madhacker3kxl/Senior-2-AlarmSystem/FinalReport.pdf

Version: (C4) | Date: 04/30/2015

“…Because Everyone Deserves to Feel Safe!”

Version: (C4)

Date: 04/30/2015

1

# TABLE OF CONTENTS

Version: (C4)
2

Version: (C4)
3

## 1. PROJECT DEFINITION

### 1.1 Functions

Ninja Security is an exciting new security system that caters to all people. Formerly designed to cater to the deaf and hard-of-hearing, Ninja Security can help keep you and your family secure regardless of special needs.

Features include:
- Loud siren to alarm owners, neighbors, and intruders that alarm system has tripped
- Flashing lights to signal alarm and alarm delays for those who cannot hear or would have trouble hearing the siren and beeps.
- Bed shaker to signal alarm during night hours for hard sleepers or deaf/hard-of-hearing.
- Door and windows sensors
- Integrated doorbell with customized tones and flash sequence to the security system for audio and visual alerts when someone arrives at the residence.
- Motion sensor to alert unwanted movement inside the home while away.
- Panic button to immediately trip alarm in case of emergencies.
- LCD interface for visual status and current updates.
- Add and remove features, expandable and customizable to meet your personal needs.

### 1.2 Customer

This system was originally geared toward the deaf and hard-of-hearing, this security system can be used by anyone. We have surveyed deaf, hard-of-hearing, and hearing people alike to determine which features are most important to them in accordance with their lifestyles. After analyzing the data from these surveys, we believe our product will be preferred over any other.

### 1.3 Team Identity

Ninja Security
- Jesse Daniels – Project Engineer

Version: (C4)
4
- Tahsin Rahman – Design & Development Engineer
- Thomas Manahl – Systems Engineer
- Chanh Tran | – Support Engineer

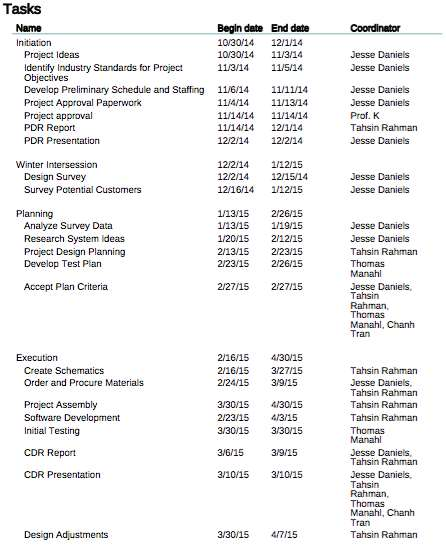
[picture p1: figure]

Version: (C4)
5

## 2. WBS

### 2.1 WBS

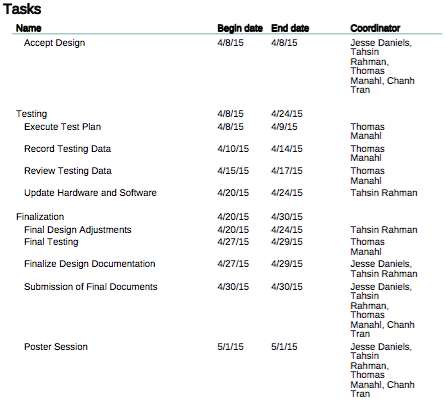
[picture p2: figure]

Version: (C4)
6

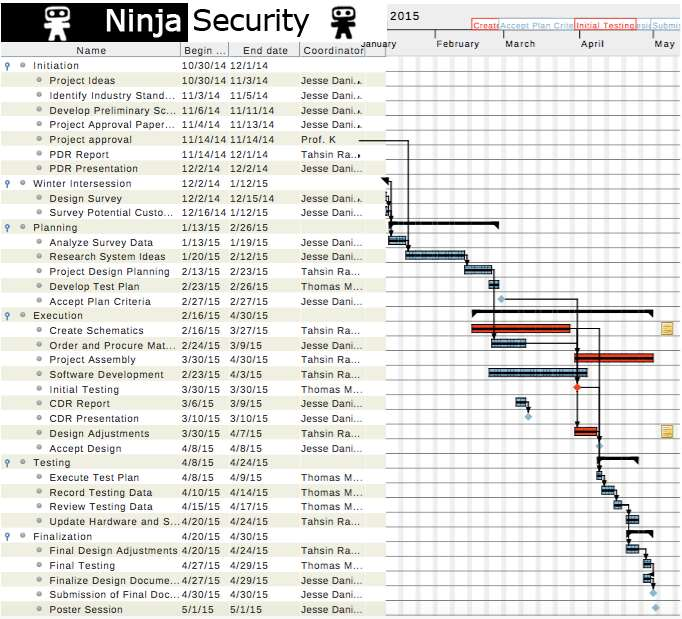
[picture p3: figure]

Version: (C4)
7

### 2.2 Schedule

- Actual Project Gantt Chart

See GANTT.pdf for larger version

## 3. SPECIFICATIONS (SUMMARY)

### 3.1 Microcontroller

- ATmega328p
- For Testing
- 8-bit
- 28 pin PDIP

Version: (C4)
8
- Operating Voltage | 1.8 – 5 Volts
- Digital I/O Pins | 14
- Analog Input Pins | 6 (10 bit)
- I/O Pin Current | 40 mA
- Flash Memory | 32 KB
- SRAM | 2 KB
- EEPROM | 1 KB
- Clock Speed | 16 MHz
- External crystal
- Detailed specification at Attachment P1
- ATtiny85
- Production
- 8-bit
- 8 pin PDIP
- Operating Voltage | 2.7 – 5 Volts
- Digital I/O Pins | 6
- Analog Input Pins | 4 (10 bit)
- I/O Pin Current | 40 mA
- Flash Memory | 32 KB
- SRAM | 512 B
- EEPROM | 512 B
- Clock Speed | 1 MHz
- Internal Calibrated RC Oscillator
- Detailed specification at Attachment P2

### 3.2 RF Modules

- Transmitter
- Frequency: 433Mhz
- Modulation: Amplitude-shift keying (ASK)
- Transmitter Input Voltage: 3-12V
- High voltage = more transmitting power
- Transmitting range @5V: 40m indoor, and 100m in open air

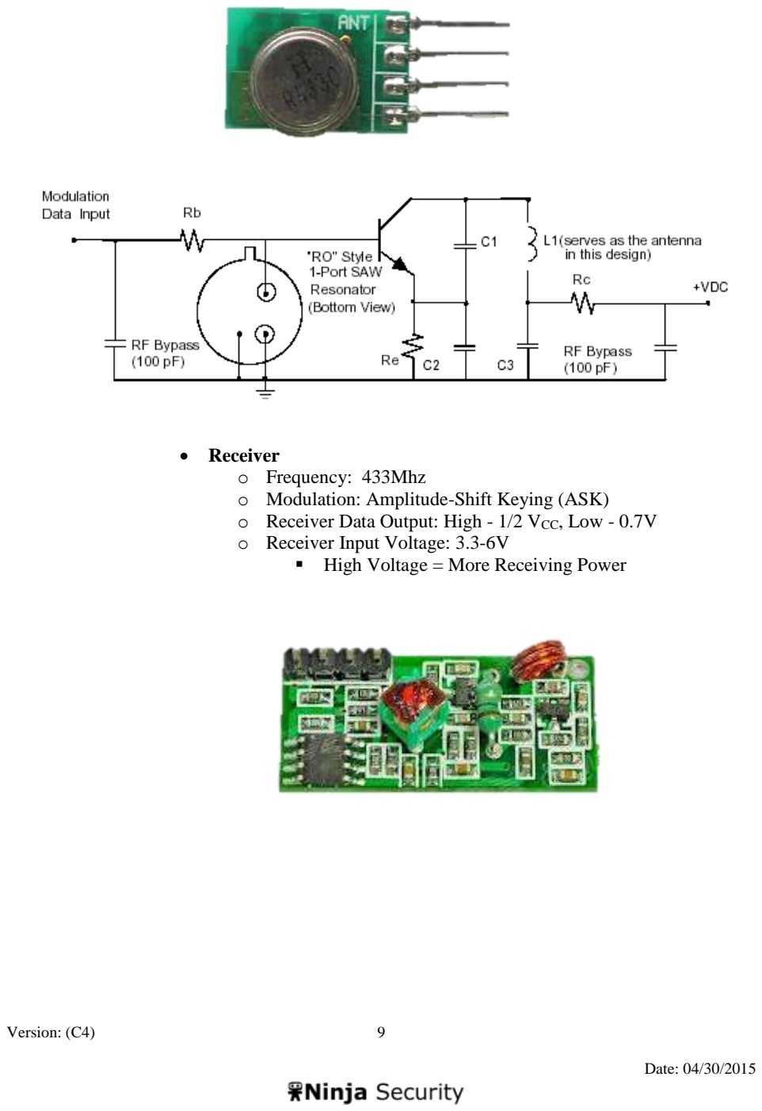
[picture p4: page 10]

Version: (C4)
9
- Receiver
- Frequency: 433Mhz
- Modulation: Amplitude-Shift Keying (ASK)
- Receiver Data Output: High - 1/2 VCC, Low - 0.7V
- Receiver Input Voltage: 3.3-6V
- High Voltage = More Receiving Power

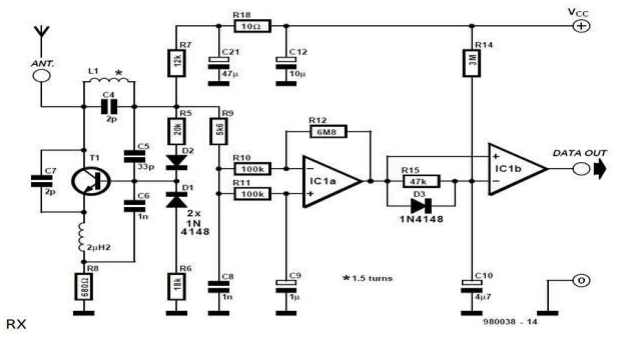
[picture p5: figure]

Version: (C4)
10

### 3.3 Sensors

- Door / Window
- Operation Current:30mA
- Idle Current: 8uA
- Operation Frequency: 433MHz
- Modulation: Amplitude-Shift Keying (ASK)
- Transmission Time: ≈ 1s
- Operating Voltage: 12V, 3V
- 12Volt for RF
- 3Volt for MCU
- Transmit Range: approx. 100M line-of-sight,
- Operation Temp: -10C~50C; Humidity: ≤90%
- Dimension: 71mm*36mm*15mm

Version: (C4)

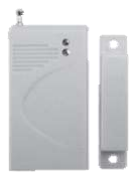
[picture p6: figure]
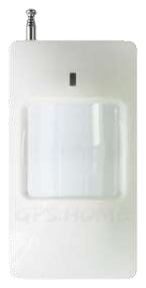
[picture p7: figure]

11

- Motion
- Power Supply : 9V
- Static current : 1 ≤ 30mA
- Alarm current : 2 ≤ 20μA
- Frequency: 433Mhz
- Transmission Time : ≧1s
- Detected Distance : 5-8m
- Transmit Distance : approx. 100m Line-of-sight
- Detect angle : Horizontal: 110, Vertical: 60
- Working Condition : Temperature : -10°C ~ 40°C (approx. 14°F ~104°)
- Panic Button / Doorbell
- Operation Current

Version: (C4)

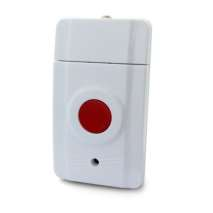
[picture p8: figure]

12

- Standby: 1uA
- Operating Current: 10mA
- Operation Frequency: 433MHz
- Modulation: Amplitude-shift keying (ASK)
- Transmission Time : ≧1s
- Operating Voltage: 12V
- Transmit Range: approx. 100M line-of-sight,
- Operation Temp: -10C~50C;Humidity:≤95%
- Dimension:65cm*38mm*15mm

### 3.4 Audio / Visual

- Fire alarm
- Modified fire alarm
- High dB Output
- up to 87.9 dBA @ 10ft
- Frequency Range 400-4000Hz
- Speaker voltage 25
- Field selectable power taps: 1/8W, 1/4W, 1/2W, 1W, 2W, 4W
- Xenon Strobe
- Maintains Constant Flash Rate (1Hz) Regardless of Input Voltage
- 75 candela light output

Version: (C4)

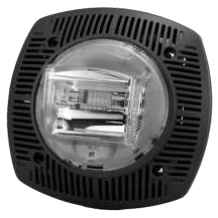
[picture p9: figure]
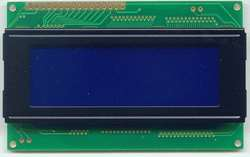
[picture p10: figure]

13

- LCD Display
- Custom alarm display box
- Operation Frequency: 433MHz
- Modulation: Amplitude-shift keying (ASK)
- Operating Voltage: 5V
- Operating Current: 100mA
- ATmega328p MCU
- 16MHz
- Capable of both sending and receiving data

### 3.5 Seismic Feedback

- Bed Shaker
- 12 volt operating voltage
- Built-in temperature sensor protects the unit against overheating
- Claims to wake up extremely heavy sleepers
- Ideal for Deaf and Hard-of-Hearing

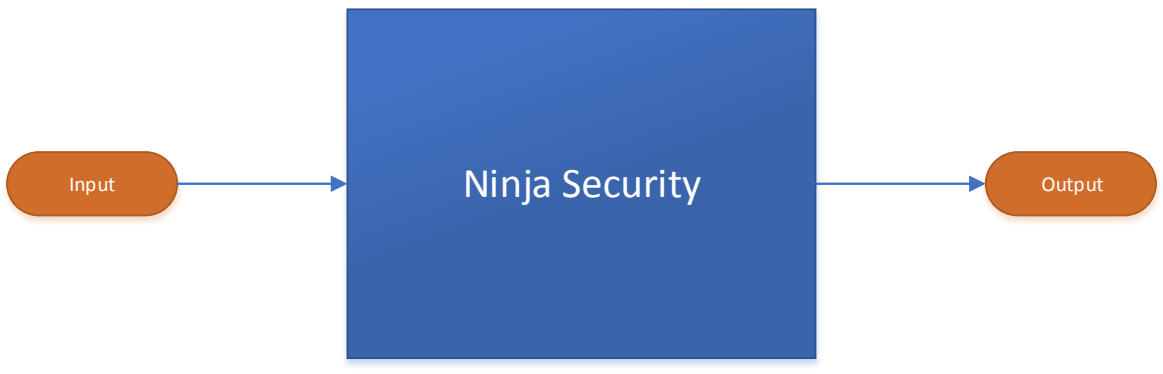
[picture p11: figure]
Input; Ninja Security; Output

Version: (C4)

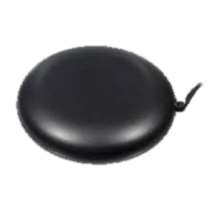
[picture p12: figure]

14

## 4. FUNCTIONAL DECOMPOSITION DIAGRAM

### 4.1 Level 0

- Input
- Various input for the main system
- Output
- Data output to various systems

### 4.2 Level 1

- Input
- Window Sensor
- Wireless magnetic window sensor
- Window opens or closes
- Door Sensor
- Wireless magnetic door sensor
- Door opens or closes

Version: (C4)
15
- Motions Sensor
- PIR based wireless motion sensor
- Movement within motion range
- Panic Button
- In case of emergencies button
- Push Button
- Door Bell Button
- Visitor at door alert
- Push Button
- Output
- Visual
- Sends data to local visual systems
- Audio
- Sends data to local audio feedback system
- Seismic
- Sends data to local vibration feedback system

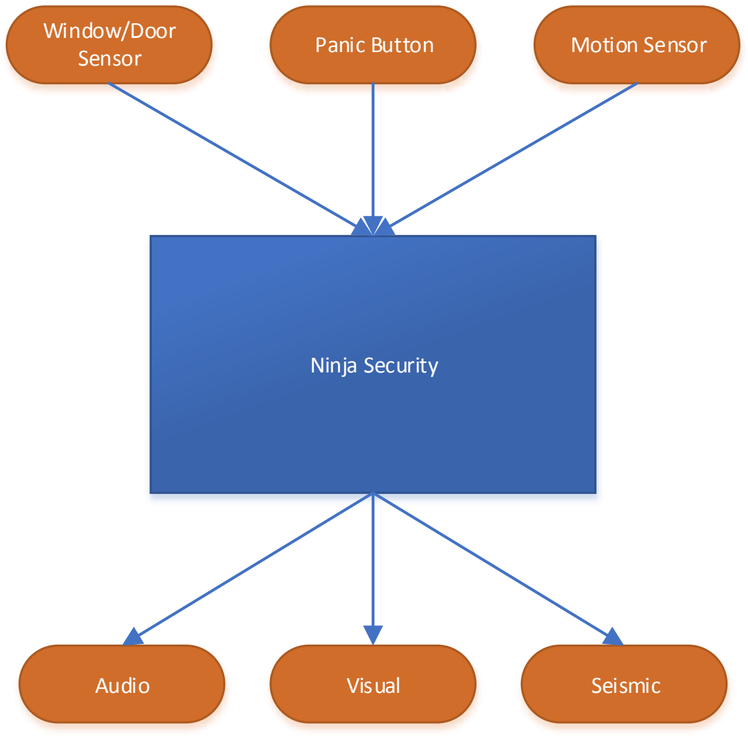
[picture p13: figure]
Ninja Security; Window/Door Sensor; Audio; Visual; Seismic; Panic Button; Motion Sensor

Version: (C4)
16

### 4.3 Level 2

- Input – Window/Door Sensor
- Battery
- 12Volt A23 Battery
- Magnets
- To open and close the magnetic relay
- Output
- RF Output
- 433MHz ASK
- Different open and close codes

Version: (C4)

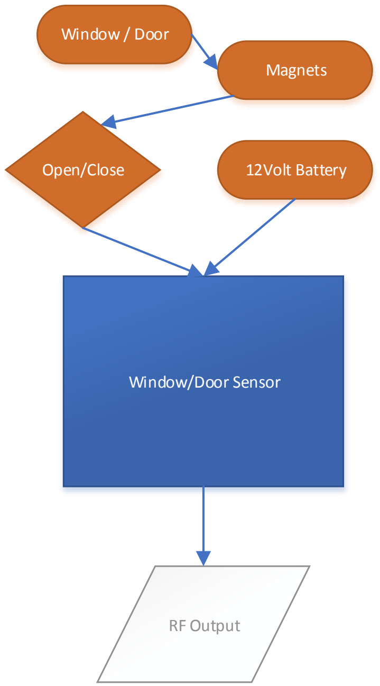
[picture p14: figure]
Window/Door Sensor; 12Volt Battery; Magnets; Open/Close; RF Output; Window / Door

17

- Input – Panic Button
- Button
- Tells the unit to send the data
- Battery

Version: (C4)

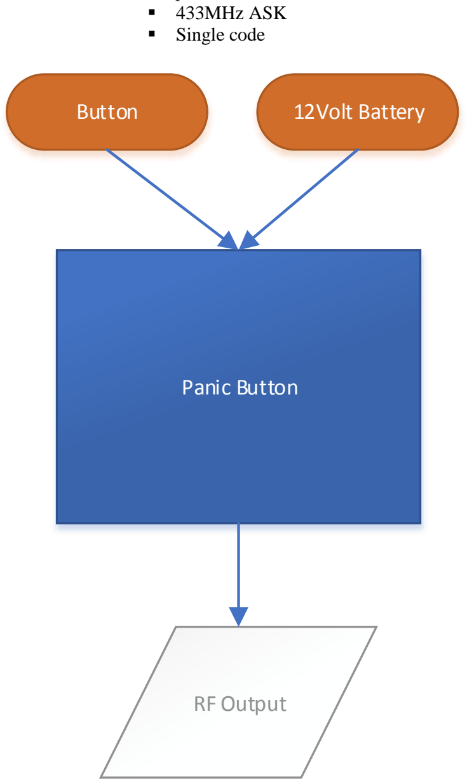
[picture p15: figure]
▪ 433MHz ASK ▪ Single code; Panic Button; Button; 12Volt Battery; RF Output

18

- 12Volt A23 Battery
- Output
- RF Output
- Input – Motion Sensor
- PIR Module
- Tells the unit to send that it detected a person
- Battery
- 9Volt Battery

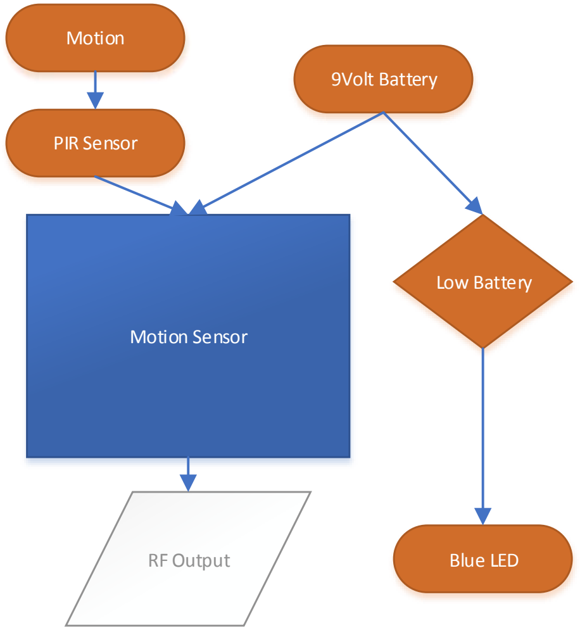
[picture p16: figure]
Motion Sensor; 9Volt Battery; PIR Sensor; RF Output; Low Battery; Blue LED; Motion

Version: (C4)
19
- Output
- RF Output
- 433MHz ASK
- Single code
- Low battery
- Blue LED is turned on for low battery
- Input – Audio Feedback
- RF Data
- RF data it received from the main system
- Power
- 12Volt AC adapter
- Output
- Speaker

Version: (C4)

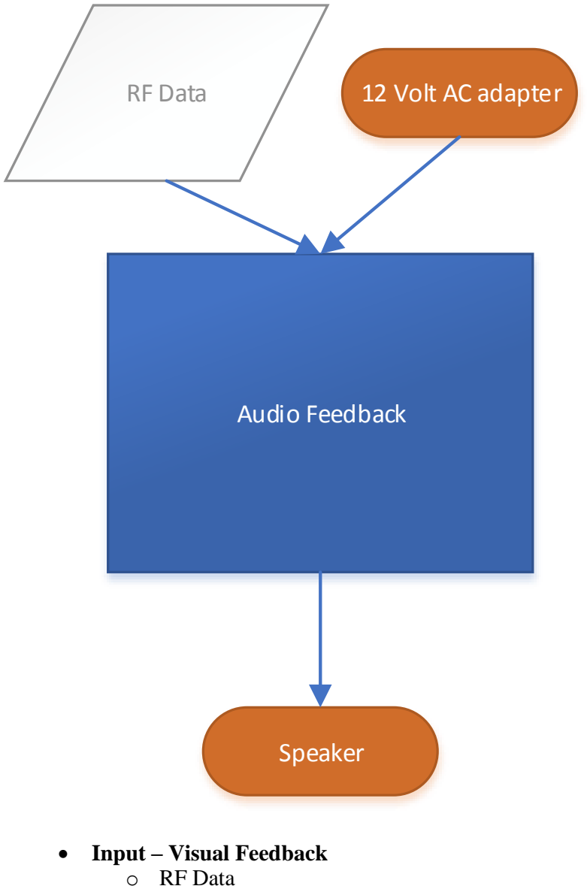
[picture p17: figure]
Audio Feedback; RF Data; 12 Volt AC adapter; Speaker; • Input – Visual Feedback • RF Data

20

- Play different sounds
- RF data it received from the main system
- Power
- 12Volt AC adapter
- Output
- Strobe
- 1Hz flashing arc strobe

Version: (C4)

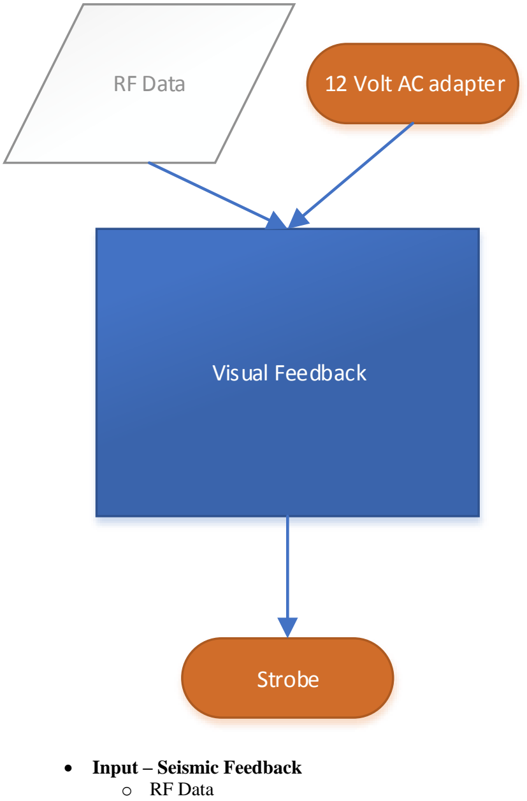
[picture p18: figure]
Visual Feedback; RF Data; 12 Volt AC adapter; Strobe; • Input – Seismic Feedback • RF Data

21

- RF data it received from the main system
- Power
- 12Volt AC adapter
- Output
- Bed shaker
- Pulsed and continuous modes

Version: (C4)

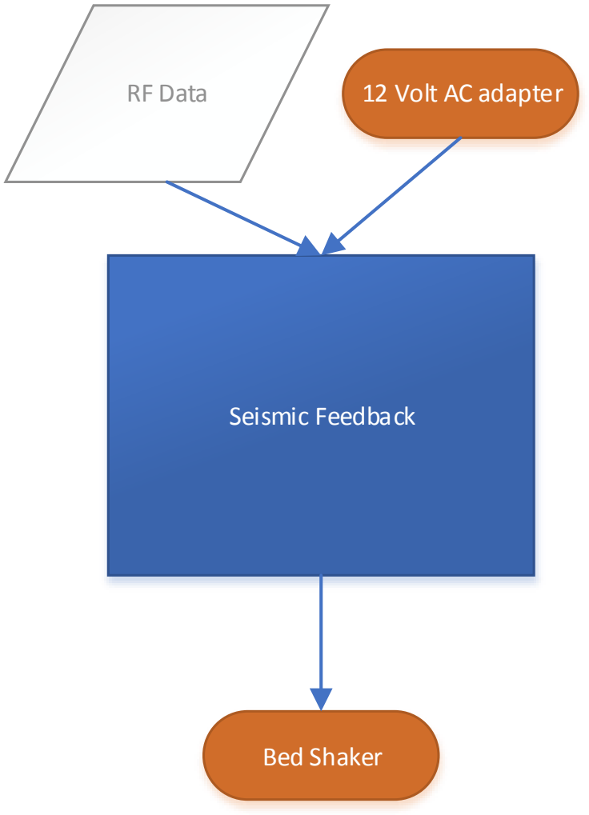
[picture p19: figure]
Seismic Feedback; RF Data; 12 Volt AC adapter; Bed Shaker

22

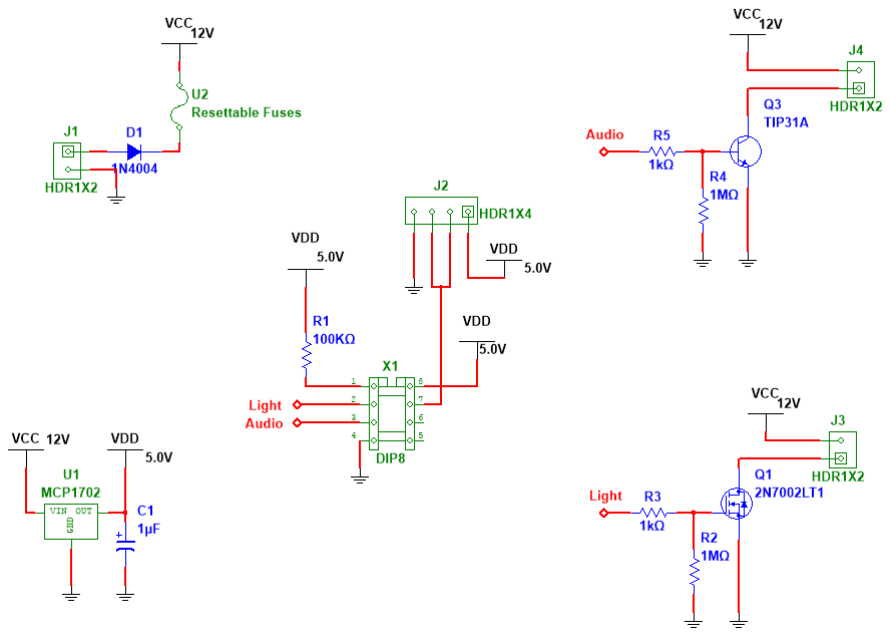
[picture p20: figure]

Version: (C4)
23

## 5.0 DESIGN CONCEPTS

### 5.1 Audio / Visual

Schematic

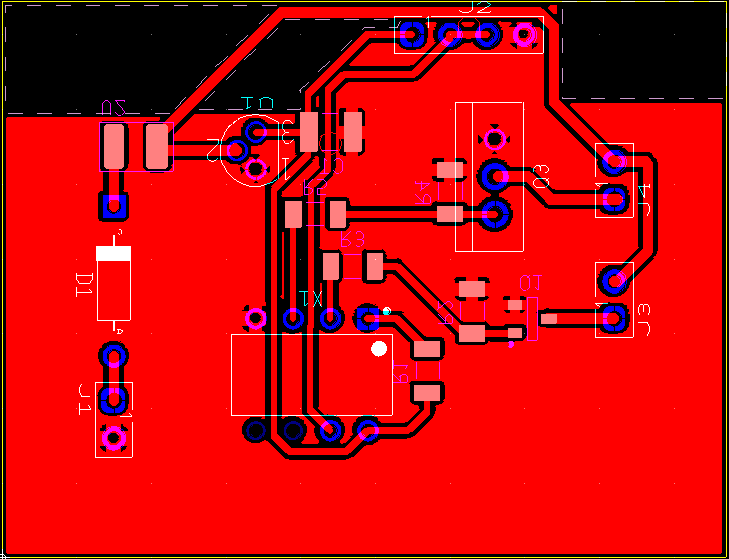
[picture p21: figure]

Version: (C4)
24

Board Layout

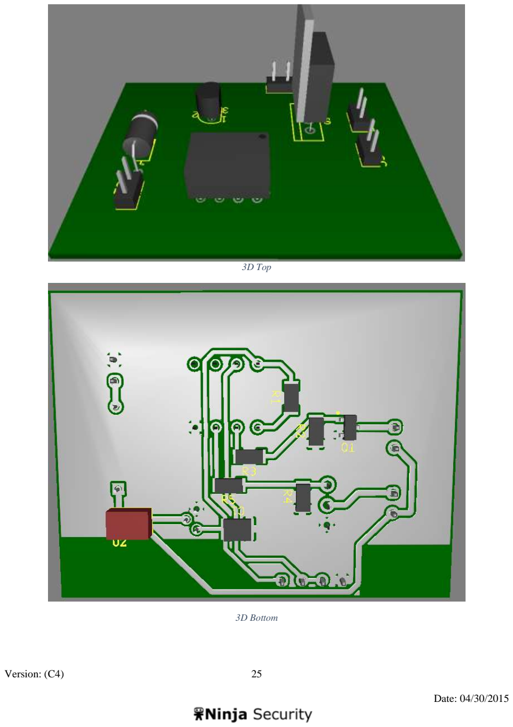
[picture p22: page 26]

Version: (C4)
25

3D Top

3D Bottom

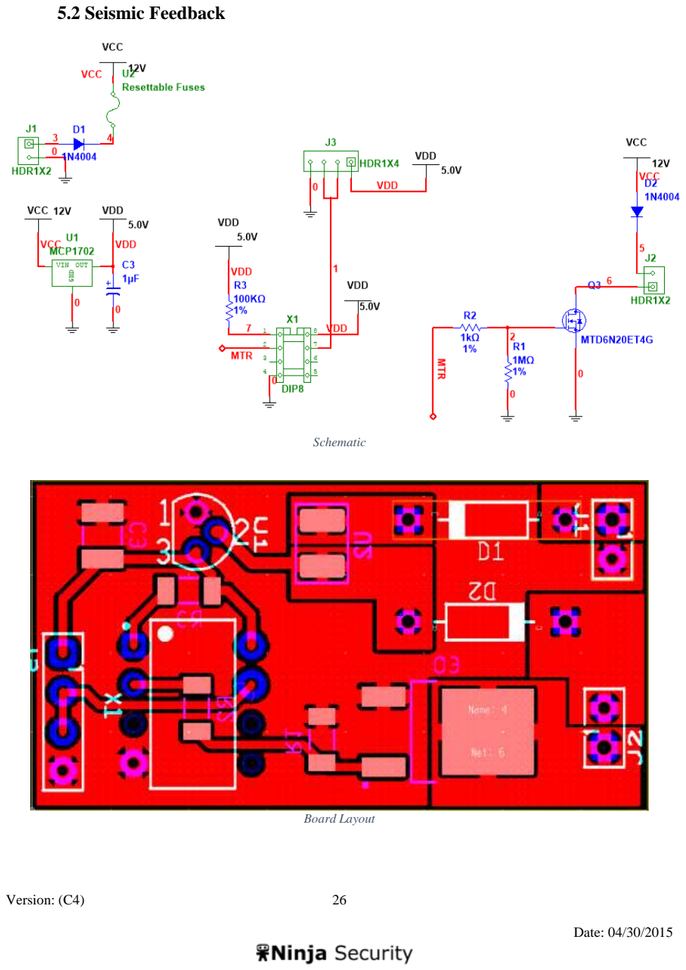
[picture p23: page 27]

Version: (C4)
26

### 5.2 Seismic Feedback

Schematic

Board Layout

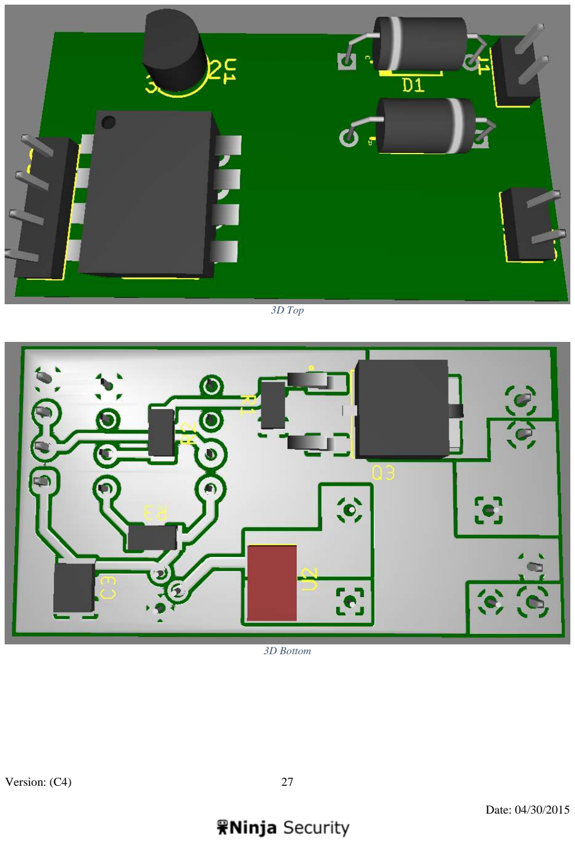
[picture p24: page 28]

Version: (C4)
27

3D Top

3D Bottom

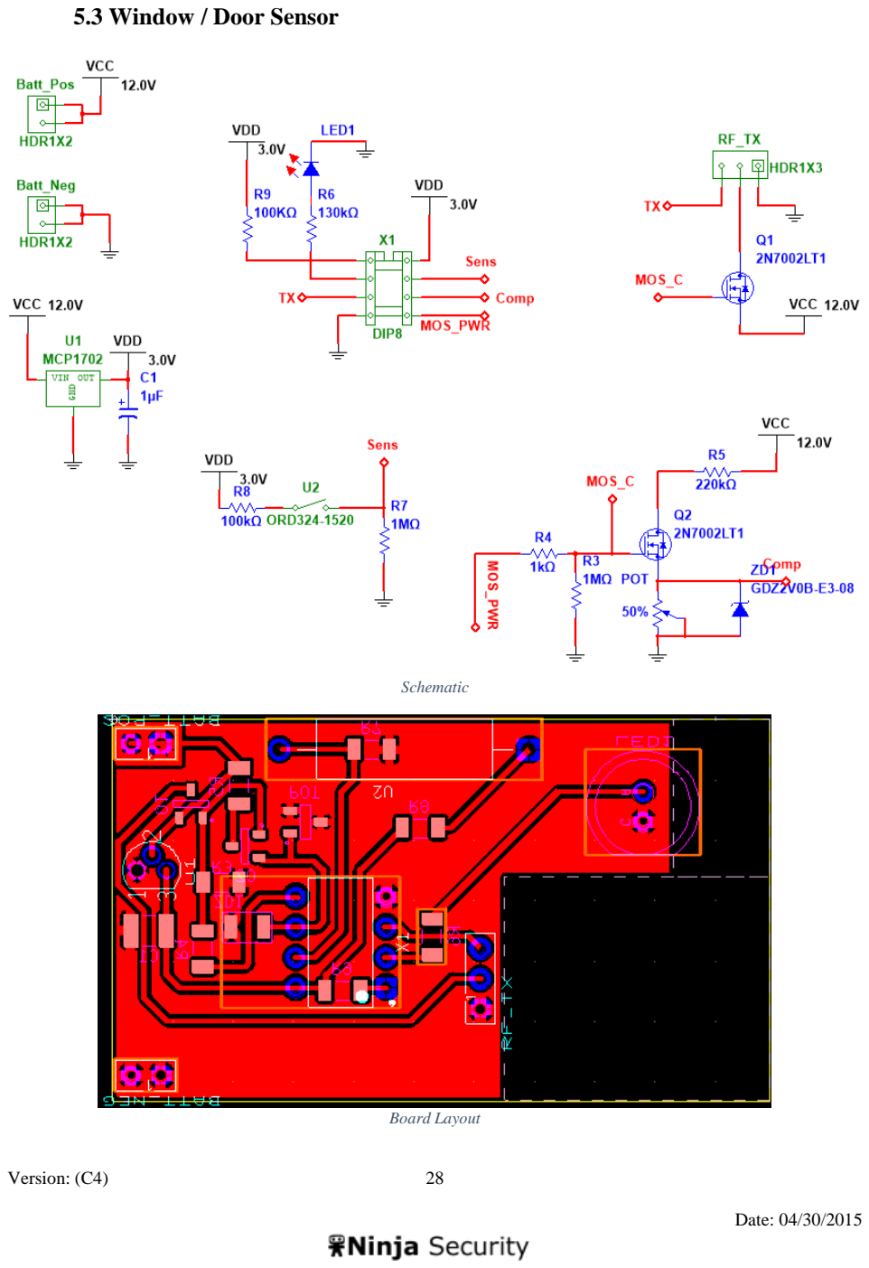
[picture p25: page 29]

Version: (C4)
28

### 5.3 Window / Door Sensor

Schematic

Board Layout

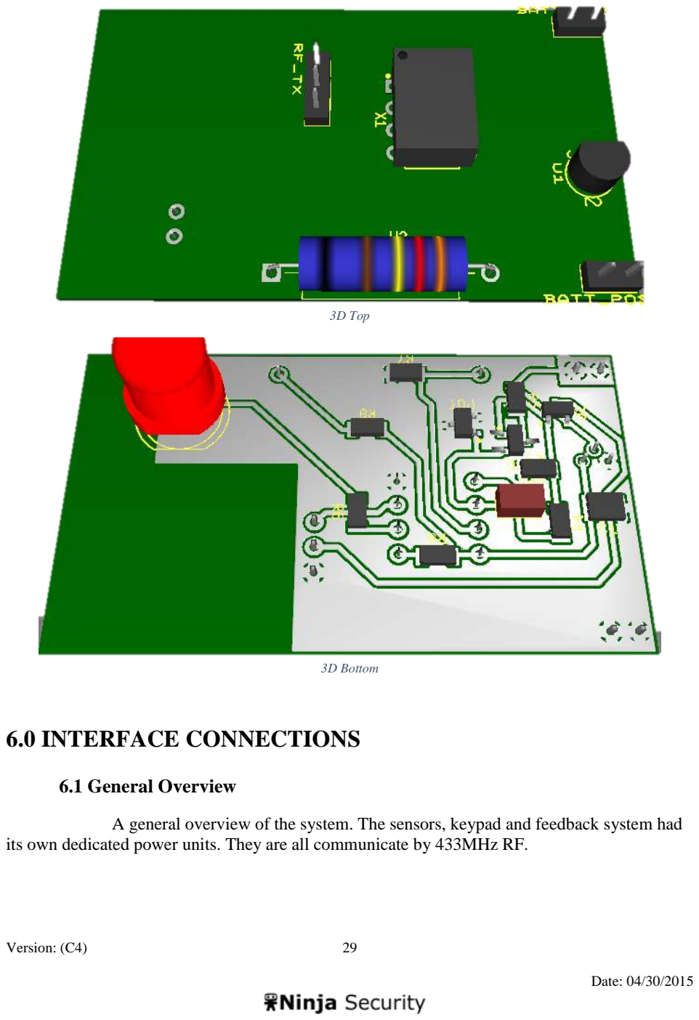
[picture p26: page 30]

Version: (C4)
29

3D Top

3D Bottom

## 6.0 INTERFACE CONNECTIONS

### 6.1 General Overview

A general overview of the system. The sensors, keypad and feedback system had its own dedicated power units. They are all communicate by 433MHz RF.

Version: (C4)

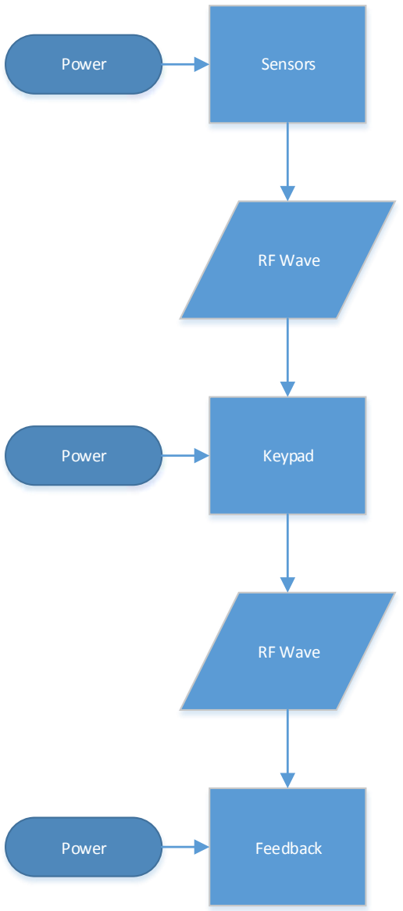
[picture p27: figure]
Keypad; Sensors; Feedback; RF Wave; Power

30

### 6.2 Display Panel

The display panel is considered as a central hub of the system. It is powered by a 12Volt adapter from the mains. The voltage regulator then converts the power to 5Volts to power the LCD, MCU, RF receiver. The MCU gets its data from the RF receiver through one of its general purpose input-output pins (GPIO). The MCU outputs data to three systems. The LCD, mini buzzer and RF transmitter is connected through GPIO pins.

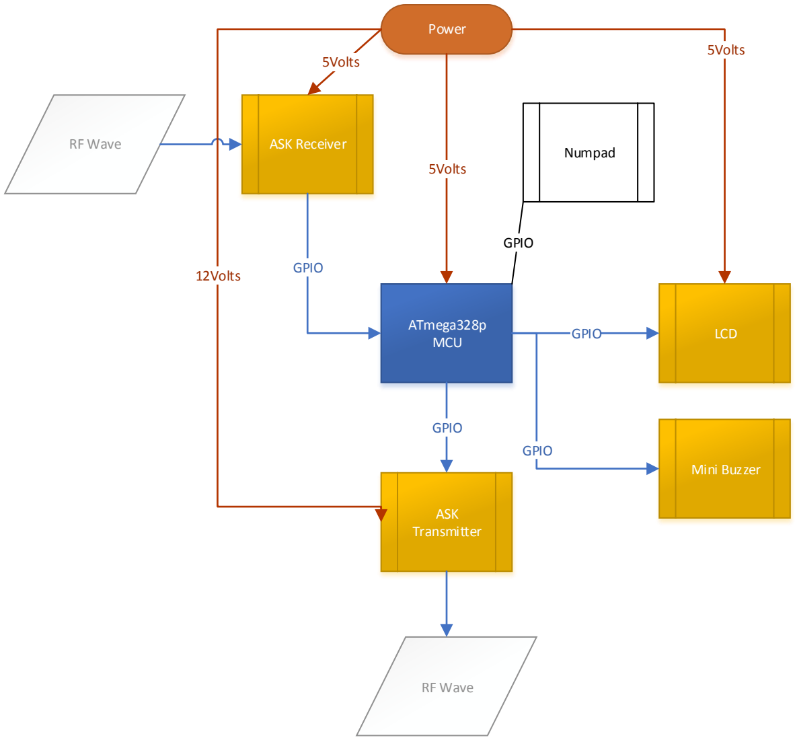
[picture p28: figure]
ATmega328p MCU; ASK Receiver; GPIO; RF Wave; Power; 5Volts; LCD; Mini Buzzer; ASK Transmitter; 12Volts; Numpad

Version: (C4)
31

### 6.3 Sensors

The motion and the panic button is powered by a 9Volt or a 12Volt A23 battery. The regulator then takes the power to 5 volts to power the BQ series device. The raw input power is also connected to the RF transmitter. The BQ series device get its input from a button / motion information through GPIO pin. Then it sends the data out to the RF transmitter using a different set of GPIO pin.

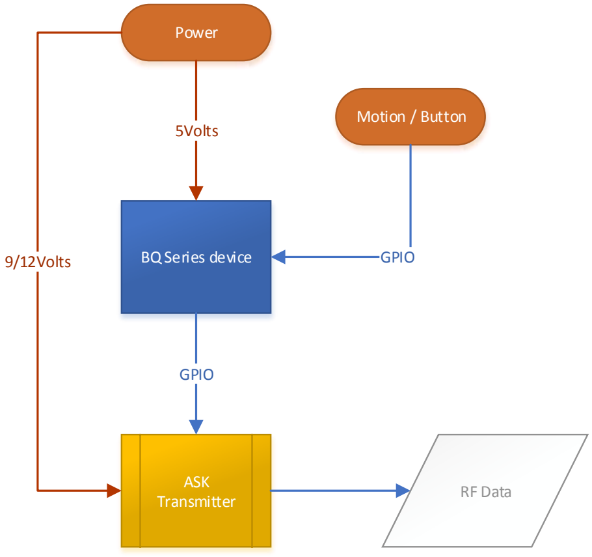
[picture p29: figure]
Power; BQ Series device; 5Volts; RF Data ASK Transmitter; GPIO; 9/12Volts; Motion / Button

Version: (C4)
32

### 6.4 Window/Door Sensor

The window / door sensor employs variety of ways to conserve power. Its main power source is a A23 12Volt battery. The voltage controller converts the 12Volts to 3Volts to power the MCU and the magnetic relay. The raw battery power also goes to the MOSFET then to the RF transmitter and the voltage divider. The MCU reads the relay information from a GPIO pin. Then turns on or off the MOSFET to power the RF module and the voltage divider. Another GPIO pin is used to send information to the RF transmitter.

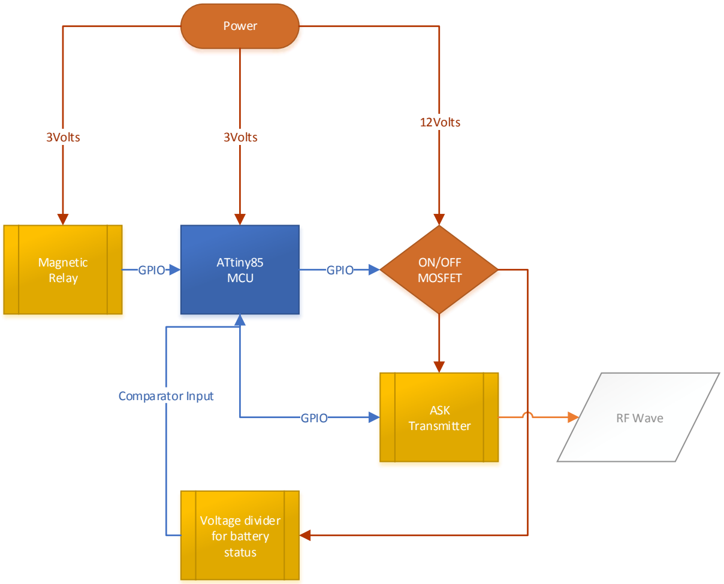
[picture p30: figure]
ATtiny85 MCU; Power; ASK; Transmitter; RF Wave; 3Volts; Magnetic; Relay; GPIO; ON/OFF MOSFET GPIO; 12Volts; Voltage divider for battery status; Comparator Input

Version: (C4)
33

### 6.5 Feedback

All feedback system has the same underlying hardware concept. There is AC power input from the mains. The mains power is converted down to 12 volts and 5 volts. The 5 volts are sent to the MCU and the RF receiver. The 12 volts are sent to the MOSFETS to control the output devices. The RF ASK receiver outputs the data in binary values. The MCU reads the data from one of its general purpose input-output pins (GPIO). The MCU also uses its GPIO pin to control the power for the output devices: e.g. strobe, bed shaker, audio alarm.

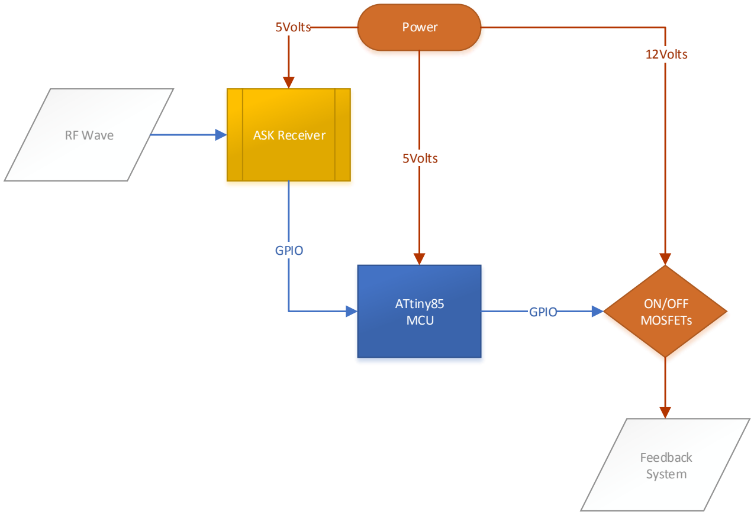
[picture p31: figure]
ATtiny85 MCU; ASK Receiver; GPIO; RF Wave; Power 5Volts; Feedback System; ON/OFF MOSFETs GPIO; 12Volts 5Volts

Version: (C4)
34

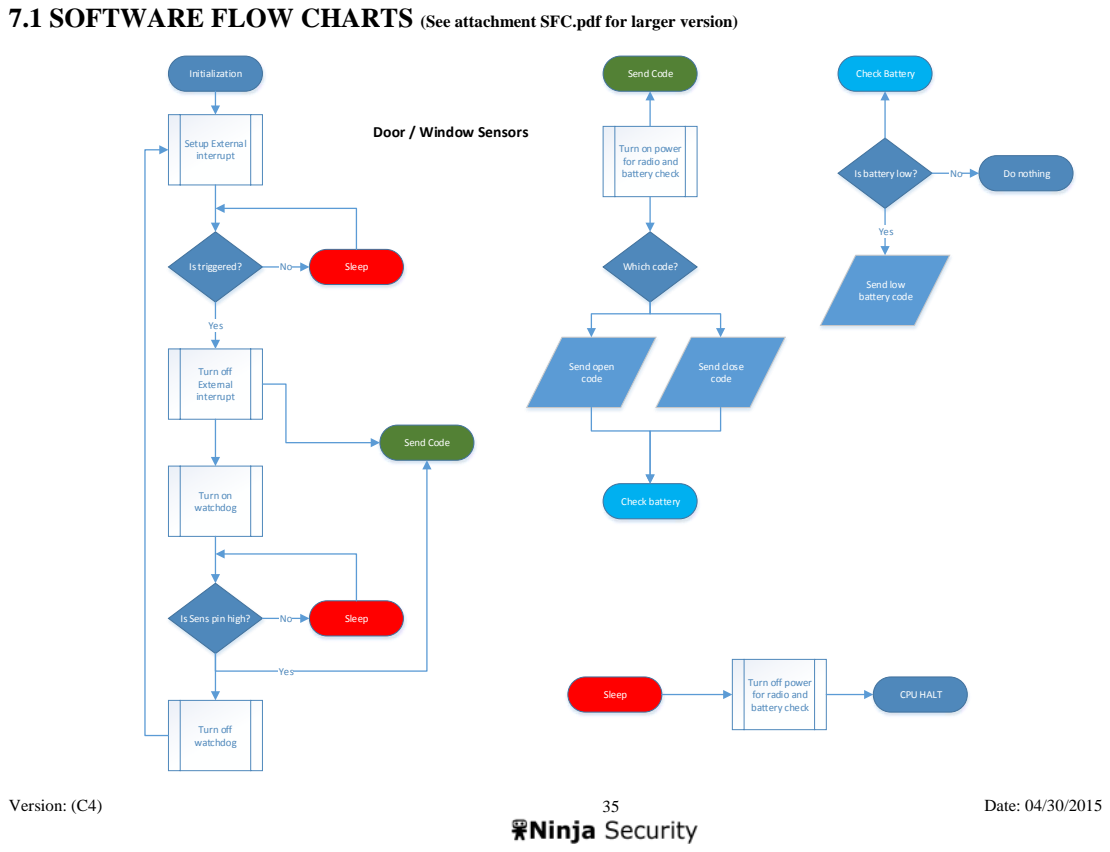
[picture p32: page 36]
Version: (C4); Date: 04/30/2015; Initialization; Setup External interrupt; Is triggered?; Sleep; Yes; Turn off External interrupt; Turn on watchdog; Is Sens pin high?; Send open code; Is battery low?; Do nothing; Send low battery code; Check Battery; Check battery; Send Code; Turn off watchdog; CPU HALT; Which code?; Send close code

7.1 SOFTWARE FLOW CHARTS (See attachment SFC.pdf for larger version)

Door / Window Sensors

Turn on power
for radio and
battery check

Turn off power

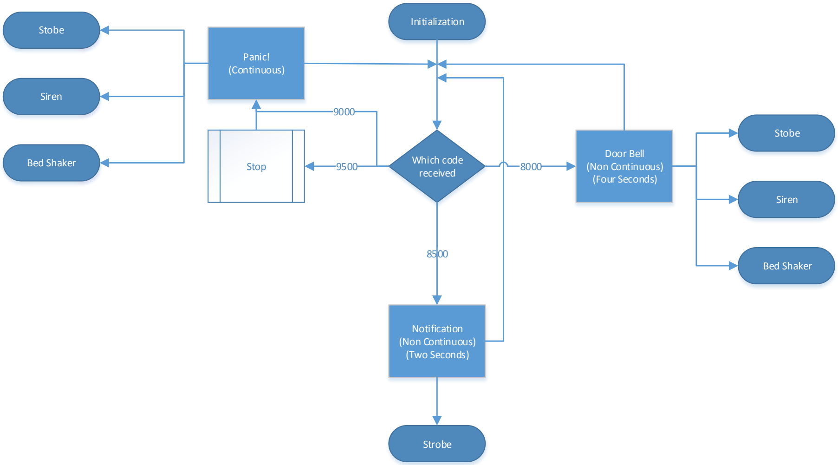
[picture p33: figure]
Initialization; Which code received; Panic! (Continuous); Stobe; Siren; Door Bell (Non Continuous) (Four Seconds); Notification (Non Continuous) (Two Seconds); Strobe; Bed Shaker; Stop

Version: (C4) | 36 | Date: 04/30/2015

### Alarm Unit

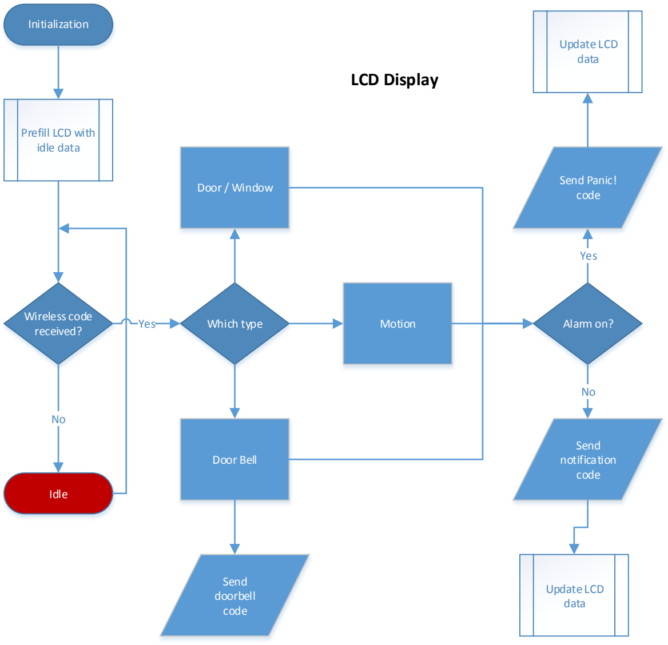
[picture p34: figure]
Initialization; Prefill LCD with idle data; Wireless code received?; Yes; Which type; Idle; Motion; Door Bell; Door / Window; Alarm on?; Update LCD data; Send doorbell code; Send notification code; Send Panic! code; LCD Display

Version: (C4) | 37 | Date: 04/30/2015
Idle | Update / Clear LCD data

Version: (C4)

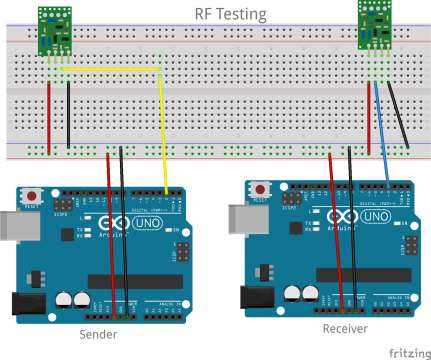
[picture p35: figure]

38

## 9.0 CRITICAL COMPONENTS

### 9.1 Measurement Instruments

- Multimeter: Used to measure voltages on the system.
- Oscilloscopes: Used for making sure the data is send correctly.
- Logic probe: Used to supplement the oscilloscope.

### 9.2 PCB Development

- Soldering iron: Used to solder things to PCB.
- Wave soldering oven: Greatly helps soldering surface mount devices.
- Milling machine: Used to mill PCB.

## 10.0 TESTING

### 10.1 RF-Transmit to RF-Receiver Communication Testing

- Arduino platform is the basis to test the RF units.
- Tests will be done at various distances to identify the range of the devices.

### 10.2 Sensor to Receiver Communication Testing

- Arduino platform is the basis to test the RF units.

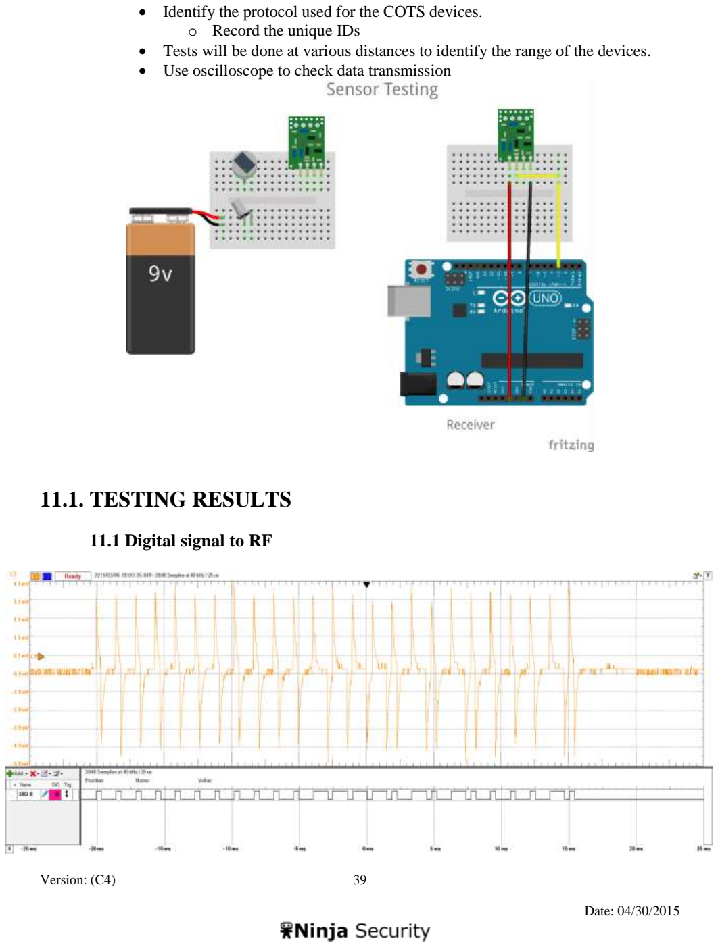
[picture p36: page 40]

Version: (C4)
39
- Identify the protocol used for the COTS devices.
- Record the unique IDs
- Tests will be done at various distances to identify the range of the devices.
- Use oscilloscope to check data transmission

## 11.1. TESTING RESULTS

### 11.1 Digital signal to RF

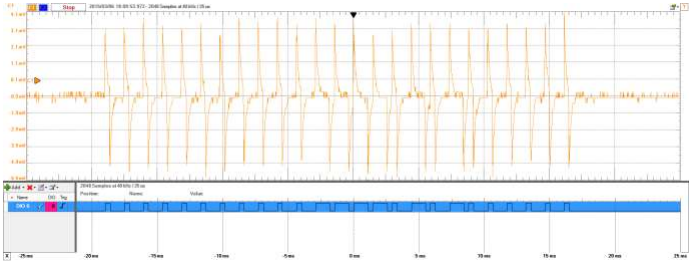
[picture p37: figure]

Version: (C4)
40

### 11.2 RF to Digital Signal

### 11.3 Antenna Testing

- Helical Antenna
- The key fob range was about 6 feet from the base station in a speed of about 1 second.
- Through Wall Testing
- Window/Door Sensor
- Had a calculated range of 73.93 feet by using Pythagorean theorem.
- Motion Sensor
- Had a calculated range of 49.4 feet by using Pythagorean theorem.
- Notice: The more dense metal in the walls the more difficult it was for the signal to reach the base station.
- Line of Sight Testing
- Window/Door Sensor went to 81.6 feet base station.
- Motion Sensor went up to 70.3 feet from base station.
- Monopole Antenna
- The FOB range was increased to 10 feet from base station.
- Through Wall Testing
- Window/Door Sensor
- Had a calculated range of 84.96 feet by using Pythagorean theorem.
- Motion Sensor

Version: (C4)
41
- Had a calculated range of 62.07 feet by using Pythagorean theorem.
- Notice: Monopole antenna worked better when we raised it higher than it did with the helical antenna.
- Line of Sight Testing
- Window/Door Sensor went to 85.5 feet from base station.
- Motion Sensor went past 150 feet but couldn’t get accurate readings past a point because it would have passed through metal doors which would interfere with the signal.

## 12. RISK / MITIGATION PLAN

### 12.1 Risks

- Sensors
- Risks
- Battery: Only 55mAh of energy.
- Range: Dependent on battery.
- Signal Quality
- Magnets for door / window sensors: Not permanent magnets.
- Signal transmit: Dependent on voltage level.
- Sensor elements: Passive Infrared (PIR) can fail.
- Electronics
- Risks
- ESD can destroy the delicate MOSFETs.
- Electrocution from AC mains.
- Burns from soldering iron

Version: (C4)
42

### 12.2 Mitigation Plan

- Battery (High Risk): It also affects the range of the transmission. In the window and the door sensors, battery life is extremely important. The analog comparator inside the ATtiny85 will be used to measure battery voltage. When the battery reaches 9 volts a low battery signal will be sent. Otherwise use a DMM to measure the voltage left in the battery and change it out. Indicator light will appear if battery needs change.
- Range (High Risk): The range is dependent on the battery. An external antenna is added to further increase the default range. To monitor this, trigger the sensors to send a signal to the base station. If the range is short change the antenna or check the battery life of the sensor or base station to see what is the cause of the range change.
- Signal Strength (High Risk): Use SDRSharp program to see the signal strength given off from each of the sensors.
- Magnets (Low Risk): Check to see if magnets still have magnetism by triggering the sensor to send a signal to the base station. If it doesn’t, put a different magnet on there.
- Signal transmission (High Risk): The sensor sends the signal three times for redundancy. Use SDRSharp program to check the signal strength of each component.
- Sensor elements (High Risk): Components can overheat so put in cool dry areas to avoid that risk. Do not place the sensors in areas like the bathroom or other humid areas.
- Radiation (Low Risk): Wireless systems have RF radiation which can affect the human body. To detect how much the system is radiating use an RF meter. If it’s too much you can turn off the system when at home then when leaving turn it back on so that one can avoid its radiation.

Version: (C4)
43

## 13. CDR APPROVALS
