madhacker3kxl/Senior-2-AlarmSystem/(list of files, drawings)

Other design files:
Schematics/Multisim/AudioVideo/AudioVideo.ms13
Schematics/Multisim/Bedshaker/bedshaker.ms13
Schematics/Multisim/Templates/lcd.ms13
Schematics/Multisim/WinDoorSensor/WinDoor.ms13
