madhacker3kxl/Senior-2-AlarmSystem/(commit log)

2015-02-24 Added bedshaker and TX sensor
    Begin working on bed shaker
    Begin working on TX Sensor
    ---TXSensor----------------------------------------
    Create code for submicro sleep.
    added analog comparitor code and interrupt
    [fire_alarm.sch, tx_sensor.sch]
2015-02-24 Added pin change interrupt and setup watchdog
2015-03-05 Change pin read for wdt logic. Change led status.
2015-03-06 Added code for fets. Fixed pin reading and logic.
    Fixed open and closed codes.
    Added codes for turning on power mosfets.
    Added data sent check to prevent sending data all the time in watchdog.
    Fixed some logic errors.
    [TX_Sensor.ino]
2015-04-03 Create initial bed shaker code
    Create bed shaker code.
2015-04-06 Removed incorrect schematic. Renamed BedShaker files.
    Removed incorrect schematic.
    Renamed BedShaker files.
    Added files for the Visual and audio feedback system.
    [fire_alarm.sch, tx_sensor.sch]
2015-04-09 Created initial schematic for bed shaker and window and door sensor
    The schematics are done in Multisim due to Eagle being weird
    [WinDoor.ms13, bedshaker.ms13]
2015-04-11 Started on Alarm Pad. Added polyfuse to Bedshaker
    [bedshaker.ms13]
2015-04-16 Added I2C keypad library. Minor changes on Alarm Pad
2015-04-21 Fix WinDoorSensor schematic. Work on Alarm pad code
    [WinDoor.ms13]
2015-04-25 Worked on Alarm Pad code and Audio Video schematic
    [AudioVideo.ms13, WinDoor.ms13, bedshaker.ms13]
2015-04-26 Finished Audio/Visual schematic and board layout
    [AudioVideo.ms13]
2015-04-27 Changed alarm light schematic
    The mosfet for the sound was underpowered so changed it to TIP317a
    [AudioVideo.ms13]
2015-06-13 Minor changes
    [WinDoor.ms13, lcd.ms13]
